ToyDr-W/PUYA_orgel_SW_BTL/image/260929_PWM_test.JPEG

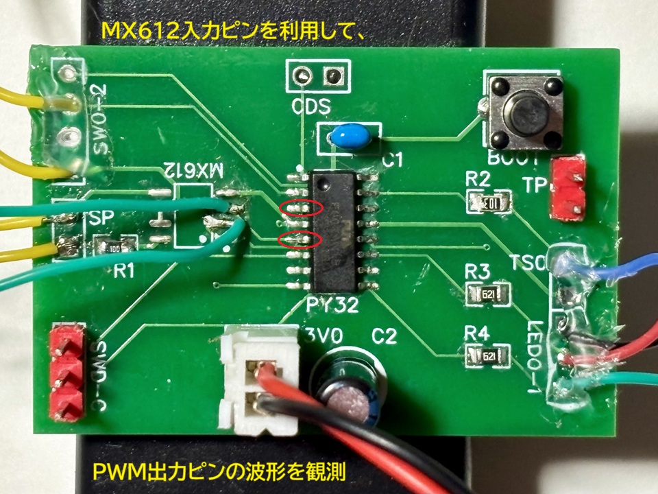
image/260929_PWM_test.JPEG
