ToyDr-W/PUYA_orgel_SW_BTL/image/260929_JLCPCB.JPEG

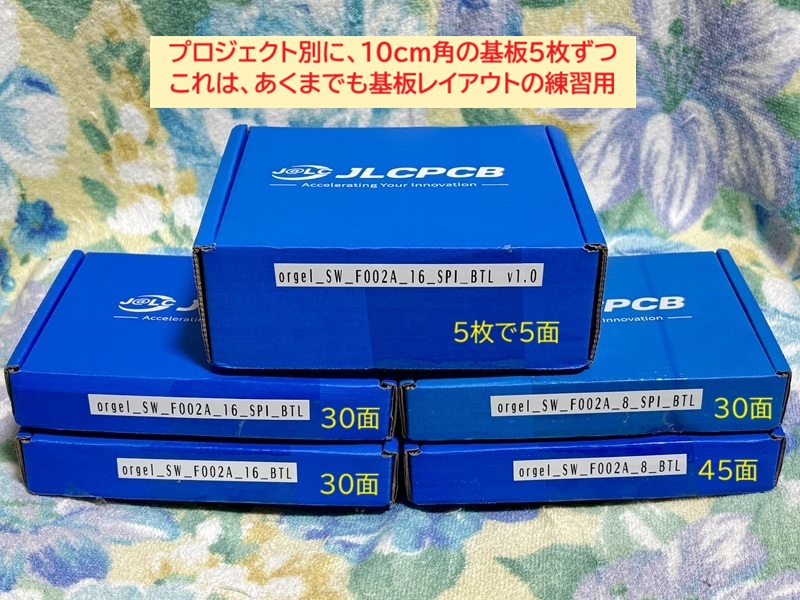
image/260929_JLCPCB.JPEG
