ToyDr-W/PUYA_orgel_SW_BTL/Circuit_Schematic/PUYA_orgel_F002A_8_BTL.png

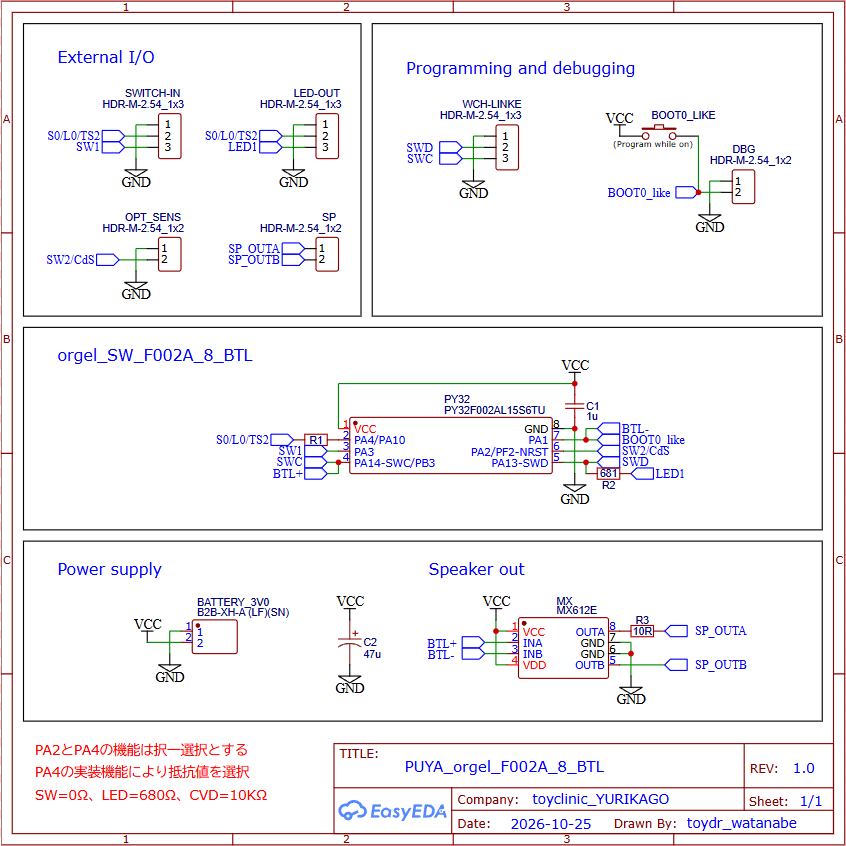
Circuit_Schematic/PUYA_orgel_F002A_8_BTL.png
