ToyDr-W/PUYA_orgel_SW_BTL/image/260921_JLCPCB.JPEG

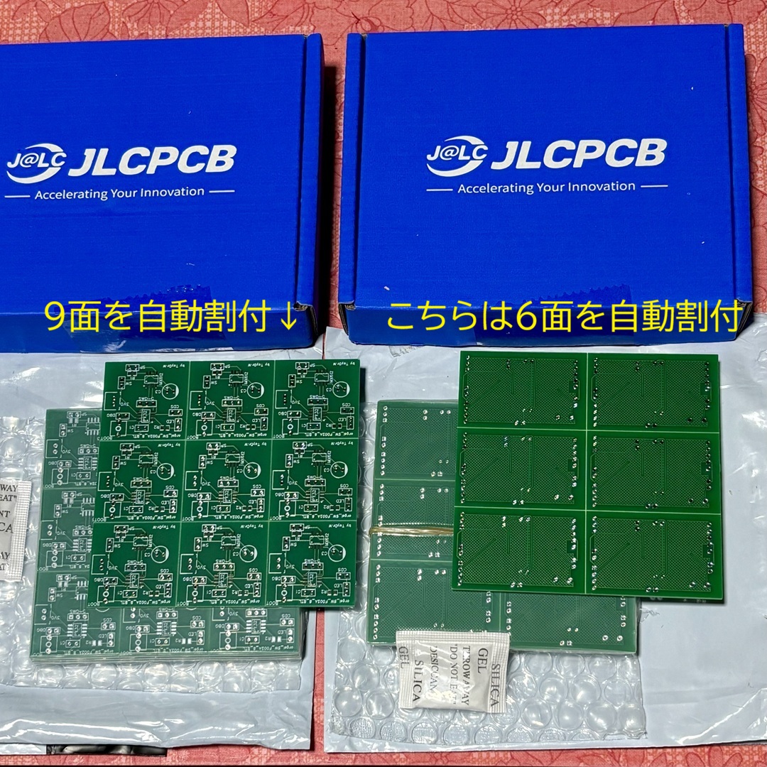
image/260921_JLCPCB.JPEG
