ToyDr-W/PUYA_orgel_SW_BTL/image/260930_prototype.JPEG

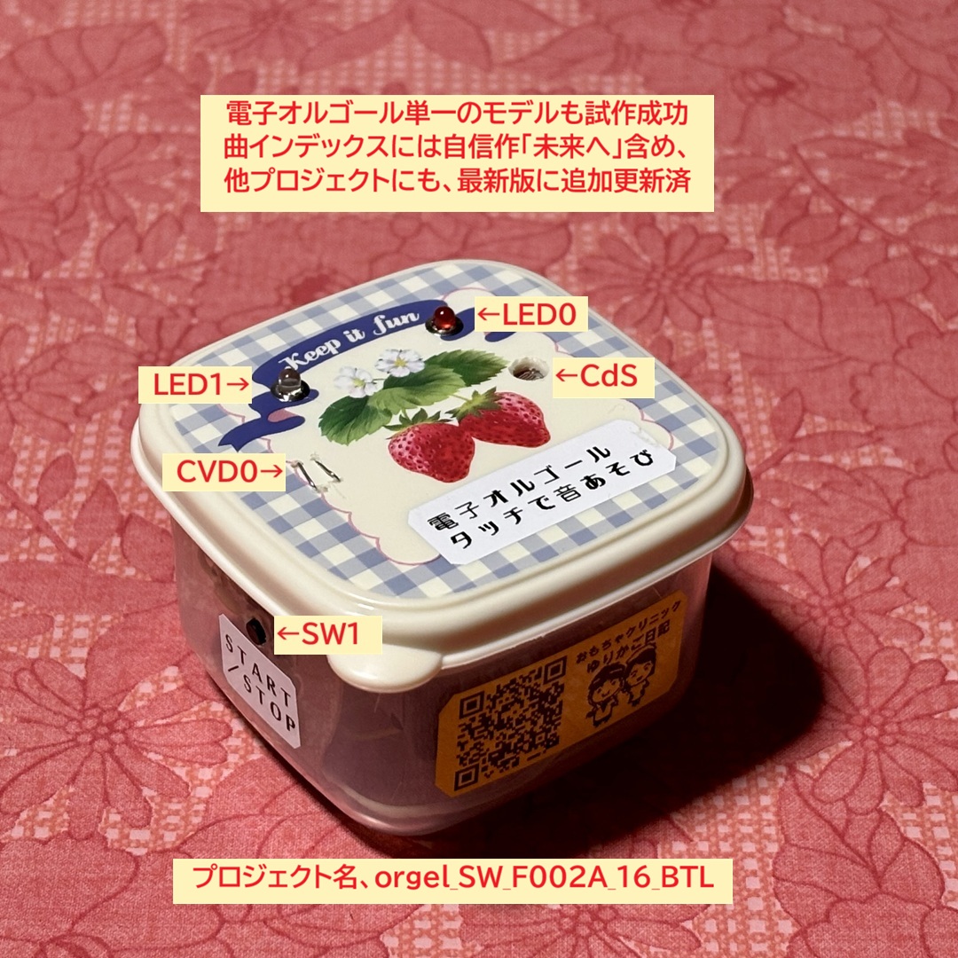
image/260930_prototype.JPEG
