ToyDr-W/PUYA_orgel_SW_BTL/PCB_Layout/orgel_F002A_8_BTL (2).png

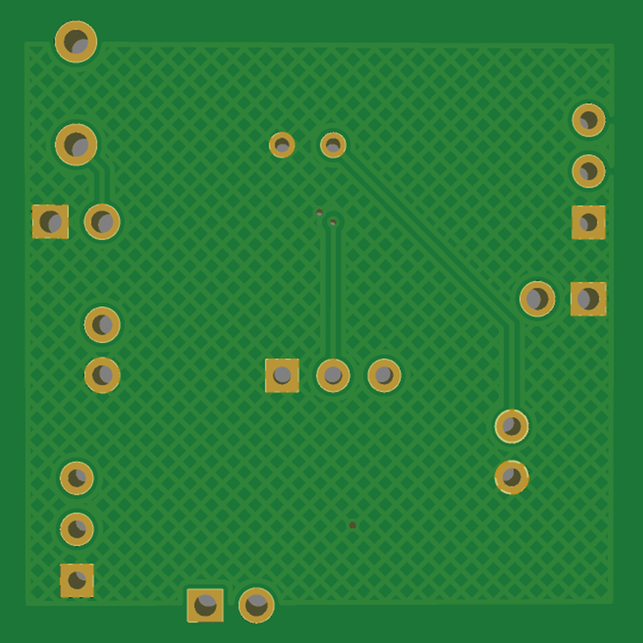
PCB_Layout/orgel_F002A_8_BTL (2).png
