ToyDr-W/PUYA_orgel_SW_BTL/PCB_Layout/orgel_SW_F002A_8_BTL_pcb (1).png

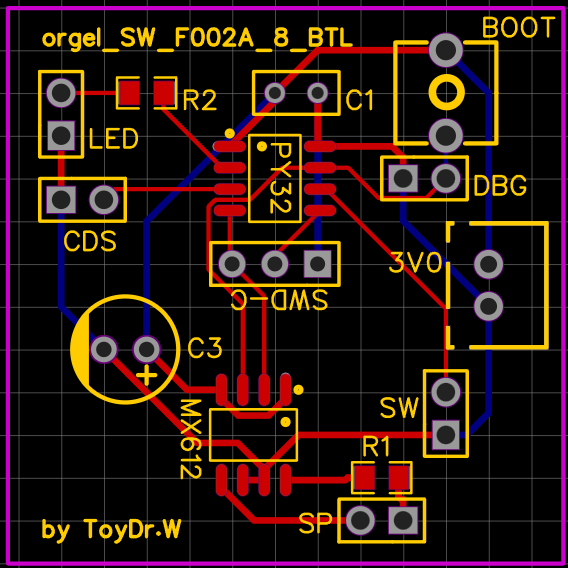
PCB_Layout/orgel_SW_F002A_8_BTL_pcb (1).png
