ToyDr-W/PUYA_orgel_SW_BTL/image/CVD_tuning_Prototype.xlsx

CVDタッチセンスのチューニング手順メモ（2026/10/1 ToyDr.わたなべ）
CVD操作のソース func_CVD.c の移動平均の直前で、ADC累積値を取得する
つまり、 DBG_S(value); のコメントを外して有効にする
さらに、デバグ情報の区切り記号「-」を挟んで、ADC移動平均の値を取得する
すなわち、DBG_S(q->cvd_ave); のコメントを外して有効にする
根のソース main.c で、SHDBG(デバグ情報取得)を宣言する
スリープ機能が機能しないように KYOKU_AUTO(自動演奏)を宣言しておく
チューニングするCVDポートを（１か所だけに絞って）実装宣言しておく
プロジェクトをリビルドして、デバイスに書き込む
テラタームで表示されたデバグログ出力を、エクセルにコピーする（16進数の文字列）
エクセルの関数で、=DECIMAL(文字列,16) と入力して、10進数値に変換する
チューニングでは、非タッチ時のADC値と移動平均との差が重要な判断材料となる
タッチ時の乖離の範囲は、下表から ｢949｣から「1576」（10進数）、
非タッチ時の乖離の範囲は、「-3」から「16」（10進数）と判読すると、
それらを CVD_CNT で除した値が判定閾値の基準となる
今回の実装環境では、タッチの有無を非常に明瞭に見分けることが出来たので、
CVD_THR2 は非タッチ時の最大値とタッチ時の最小値の中間値を基準とする
CVD_THR1 はヒステリシス性を持たせる意味から、その半分を基準とする
つまり、CVD_THR2＝(949-16)/5/2=93 、CVD_THR1=93/2=47、
CVD_INC は CVD_THR2の10%程度、つまり、CVD_INC=93*.1=9 とする
実機にて、CVDタッチと非タッチを繰り返した
デバグ情報（16進数） |  | 10進数に変換した数値
value | q->cvd_ave | value | q->cvd_ave | その差
0BC7 | 0BC7 | 3015 | 3015 | 0 | ↓非タッチ
0BC8 | 0BCB | 3016 | 3019 | -3
0BC7 | 0BC7 | 3015 | 3015 | 0
0BC8 | 0BCB | 3016 | 3019 | -3
0BCA | 0BCA | 3018 | 3018 | 0
0BCC | 0BCE | 3020 | 3022 | -2
0BCB | 0BCB | 3019 | 3019 | 0
0BC8 | 0BC8 | 3016 | 3016 | 0
0BCB | 0BCC | 3019 | 3020 | -1
0BCB | 0BCB | 3019 | 3019 | 0
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
