ToyDr-W/PUYA_orgel_SW_BTL/261001_CVD_tuning.jpg

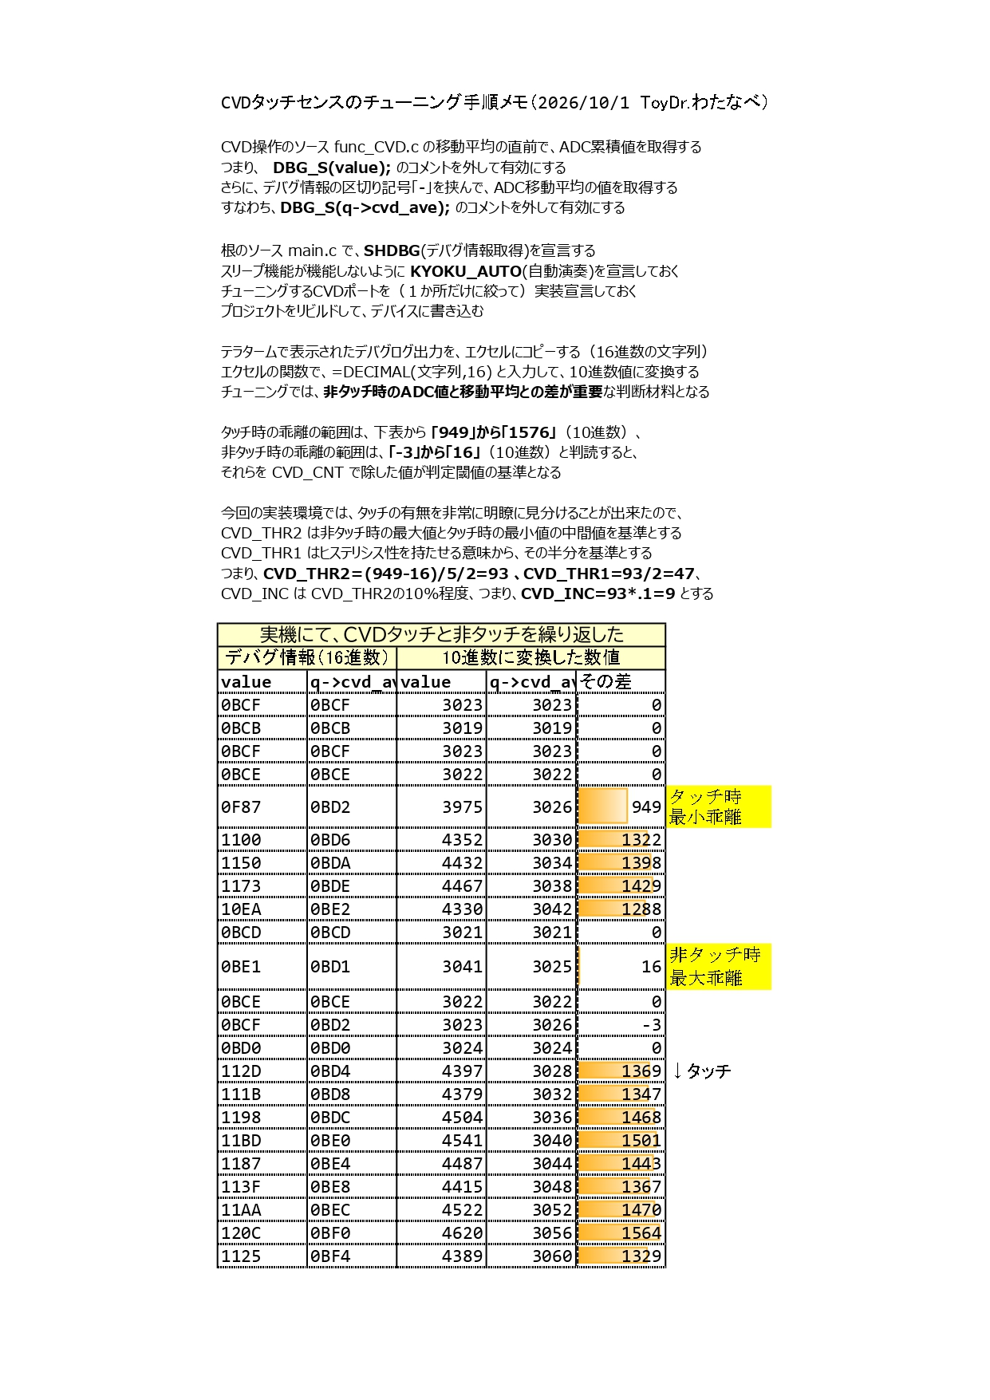
261001_CVD_tuning.jpg
