ToyDr-W/PUYA_orgel_SW_BTL/Circuit_Schematic/PUYA_orgel_F002A_16_BTL.pdf

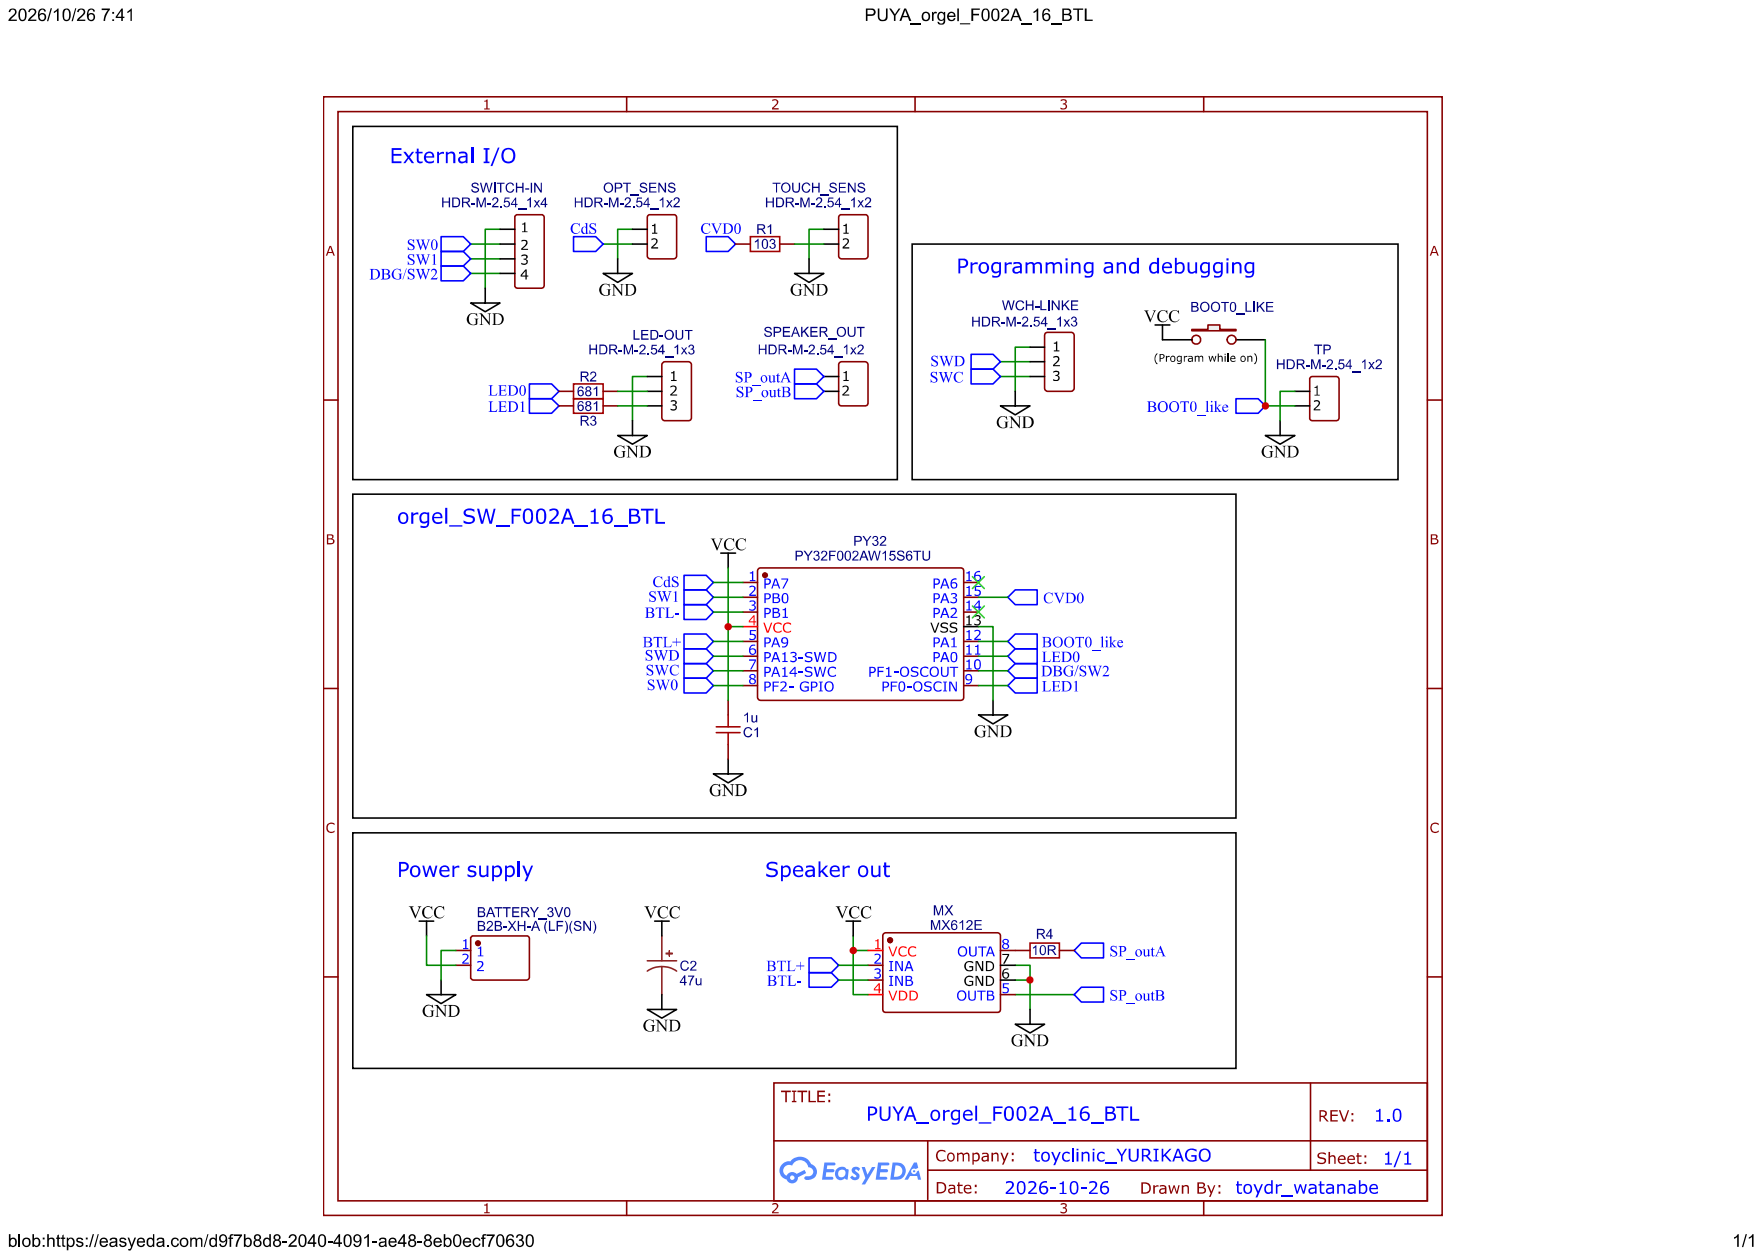
[picture p18: page 1]
