ToyDr-W/PUYA_orgel_SW_BTL/orgel1_4_260929/orgel_SW_F002A_16_BTL/orgel_cnf.h

#define SYS_CLK 48 
#define BTL 3 
#define PWM_STEP 1024 
#define PWM_FRQ (SYS_CLK*1000/PWM_STEP) 
#define PWM_PR (PWM_STEP/SYS_CLK) 
#define PWM_DB_CMP 0x10 
#define PWM_DB_BRG 10 
#define OUT_BUF_N 50 
#define SPI_BUF_N 8 
#define SONG_PS 2 
#define KOYUU_PR 32 
#define VOICEN0_VOL 80 
#define VOICEN1_VOL 100 
#define VOICEN2_VOL 100 
#define VOICEI_VOL 100 
#define VOICEC_VOL 100 
#define VOICES0_VOL 100 
#define VOICES1_VOL 100 
#define VOICES2_VOL 100 
#define ORGEL_VOL 80 
#define KB0_VOL 100 
#define KB1_VOL 100 
#define VOICE_N 1 
#define VOICE_I 0 
#define VOICE_C 0 
#define VOICE_S 0 
#define PART_N 4 
#define KB_N 0 
